petegee/PMS2/Builds/01/PMS2.jpg

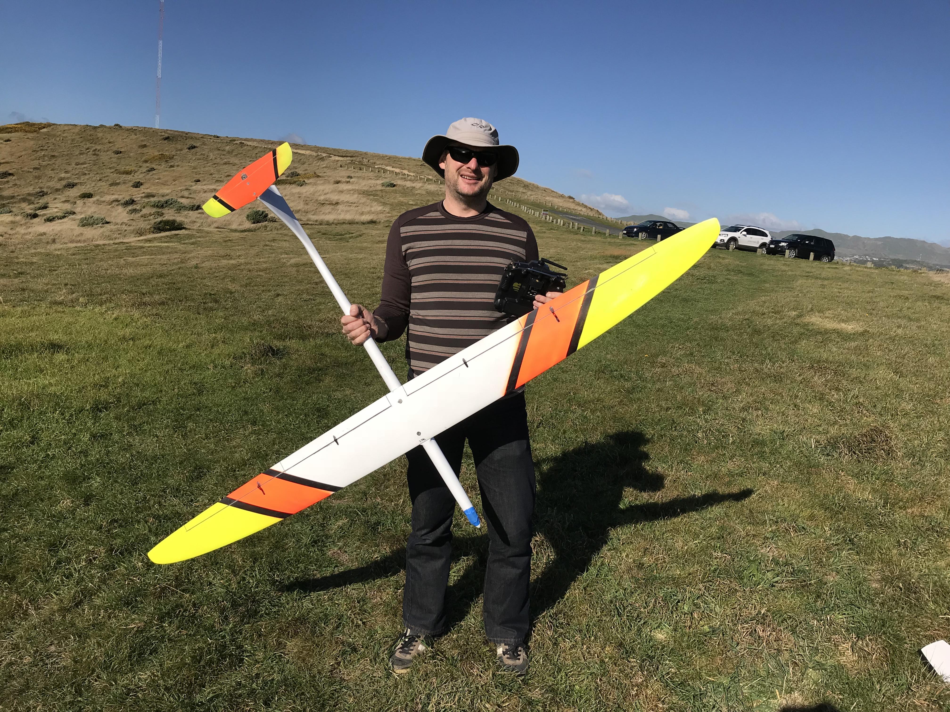
Builds/01/PMS2.jpg
