petegee/PMS2/README.md

# PMS2
A complete record of the PMS mk2 Dynamic Soaring sailplane
