petegee/PMS2/Plans/Wing/Linkages/ReadMe.md

# PMS 2 linkages

How to use these files:
1. Download and install Processing https://processing.org
2. Put the 3 folders (adjacent to this file) under the root install directory of Processing.
   you should have:
   * /pms2_flap/pms2_aileron.pde
   * /pms2_aileron/pms2_aileron.pde
   * /pms2_aileron_tophinged/pms2_aileron_tophinged.pde
3. Open one of the .pde files with processing.
4. Click the run button

https://github.com/projectkk2glider/servo-linkage
