petegee/PMS2/Plans/Overview.md

# P.M.S. mk2 

Poor Mans' Sloper Mk2 (PMS 2) is a scaled-down to 2 meter version of the PMS 3 meter slope-soarer original designed and built by Dave Pope, which was a 2-piece vac-bagged wing. The PMS 2 is intended to be a single-peice wing, heavy-weight, high-aspect, Dynamic Soaring glider which is built to be very strong and break the 300MPH barrier for local Wellington DS pilots.

The initial prototype PMS 2 was built by Dave Pope with a vac-bagged foam-cored triple-tapered elliptical plan-form with a fuselage mold built from a turned wooden plug and created from poly resin and chopped-matt glass. The air-foils were designed by Sean Malloney and are designed first and foremost for Dynamic Soaring, producing excellent DS performance from 200-400MPH with average front-side sloping performance yet being docile enough to slow down for launch and landing.

The wing moulds were build several years later by Pete Glassey. The wing design and mold CAD work was done by Joe Wurts. The CAM 3D CNC milling was done by Peter Williams. The moulds were milled from laminated corian bench-top material. 

## CoG Caclulations (old)
Note: this is based on original triple-tapered prototype planform; which should be close enough as a starting point.
https://www.ecalc.ch/cgcalc.php?deeplink=PMS%202%20(orig%20planform);cm;17;15.5;12.2;7.2;0;0;0;1.7;5;0;0;40;35;25;0;0;0.85;9;5;0;0;0;0;3;0;0;0;0;16;%20;%20;%20;0;82;25;10;

## Changes:

* new horizontal stabiliser mold has been CAD/CNC manufactured by Don Tester
* new Fuselage mold has been CAD designed and will be CNC cut sometime this year (2020) out of corian by Pete Williams

New calcs:
https://www.ecalc.ch/cgcalc.php?deeplink=PMS%202;cm;17;15.5;12.2;7.2;0;0;0;1.7;5;0;0;40;35;25;0;0;0.85;8.5;5;0;0;0;0;3;0;0;0;0;17.7;0;0;0;0;78.1;25;10;
