petegee/PMS2/Builds/01/Overview.md

# PMS2 Build no. 1 (DESTROYED)

# Objective
Build a functional mid-weight carbon version for general use and proving the wing mould for PG.

# Details 
* Owner: PG
* Maiden @ Titahi Bay May 2018
* DS Maiden @ Ngaio June 2018
  
# Parts:
1. Fuselage built by Jono using original hand-made mould
2. Wing built by PG using new CNC corian moulds
3. Stab bagged foam - cut by DP, baggged by PG.

# Speeds:
* 221 MPH June 2018
* 250 MPH Jan 2019 (RIP)
