petegee/PMS2/Plans/CGCalcBasedOnPrototypePlanform_with_mk2_fuselage_and_mk2_stab.md

Click the perma-link for the calculations for the PMS2 based on:
1. Prototype wing planform (triple-tapered), not exactly the same as the final CAD wing
2. Using the dimensions of the new Mk2 fuselage
3. Using the planform of the new Mk2 stabiliser

Results of calculation below are to be taken as a guide only.

https://www.ecalc.ch/cgcalc.php?deeplink=PMS%202;cm;17;15.5;12.2;7.2;0;0;0;1.7;5;0;0;40;35;25;0;0;0.85;8.5;5;0;0;0;0;3;0;0;0;0;17.7;0;0;0;0;78.1;25;10;
