petegee/PMS2/Plans/NewStab/Details.md

# Mk2 Horizontal Stabiliser Details

A new horizontal stabiliser CAD/CNC mould has been made to replace the hand-made hot-wired/bagged ones with the following measurements:

# Dimensions
* Span 340mm
* Root Chord 85mm
* Tip chord 55mm
* TE Swept forward 14mm at each end.
* Flap is cut 25mm at root from TE and is 250mm in length (will be 13.5mm at ends from TE)
* 2x Mount holes are along the centreline at 15mm from LE, and 46 from the TE.
* Section: T.B.C. (but generic symetrical stabiliser section)
