petegee/PMS2/Plans/Stab/Details.md

# Horizontal Stabiliser Details

# Dimensions
* Span 320mm
* Root Chord 90mm
* Tip chord 55mm
* TE Swept forward 14mm at each end.
* Flap is cut 26mm at root from TE and is 240mm in length (will be 14mm at ends from TE)
* 2x Mount holes are along the centreline at 15mm from LE, and 46 from the TE.
* Section: T.B.C. (but generic symetrical stabiliser section)
