petegee/PMS2/Plans/Fuselage/Details.md

# Fuselage Details

## General Dimensions
* length: 1200mm 
* Nose moment (from LE of wing) 300mm
* Wing root chord (saddle length) 170mm
* Tail moment (from wing TE to stab LE) 650mm
* Tail mounted 130mm above fuselage datum
* Incidence angle (wing/stab) 0 degrees
