petegee/PMS2/Plans/Wing/Prototype info/PMS 2 Wing 02.pdf

170 | 155
400 | 350 | 250

122
72 Flap and aileron hinge: 80% chord

17
33
SM PMS 2 Root | SM PMS 2 Root | SM PMS 2 Mid | SM PMS 2 Tip
