petegee/PMS2/Plans/CGCalcBasedOnPrototypePlanform.PNG

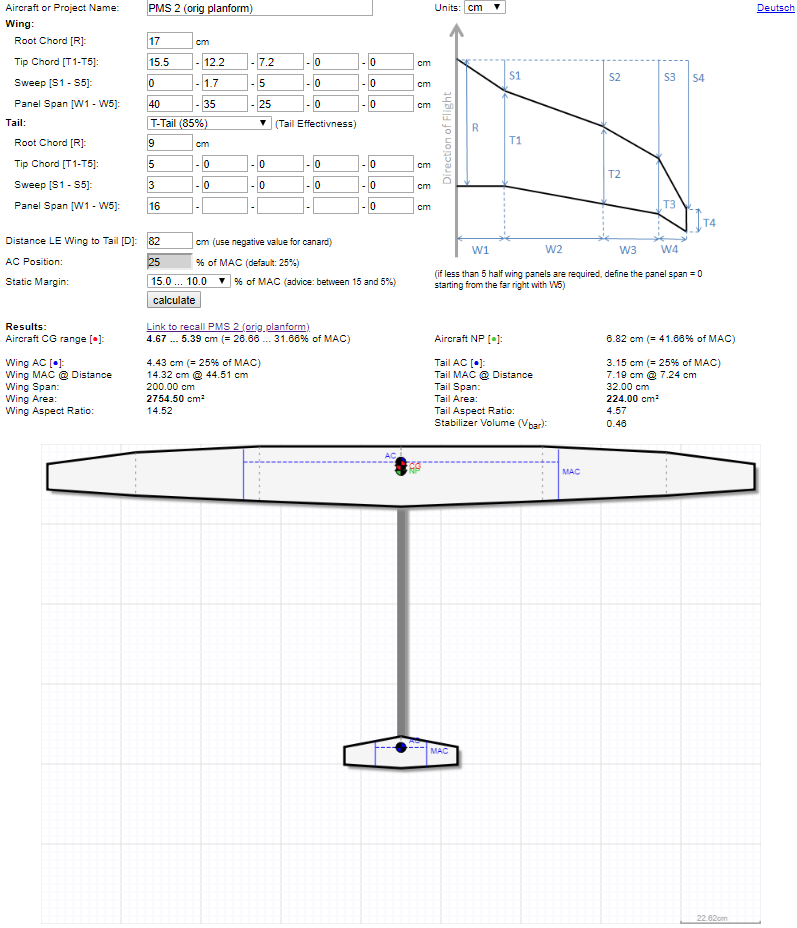
Plans/CGCalcBasedOnPrototypePlanform.PNG
