petegee/PMS2/Plans/NewFuselage/fairing-detail.png

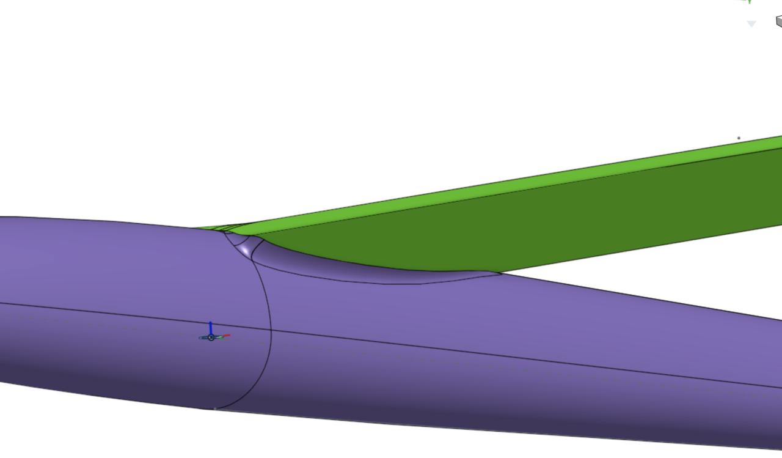
Plans/NewFuselage/fairing-detail.png
