petegee/PMS2/Plans/NewFuselage/SideView.JPG

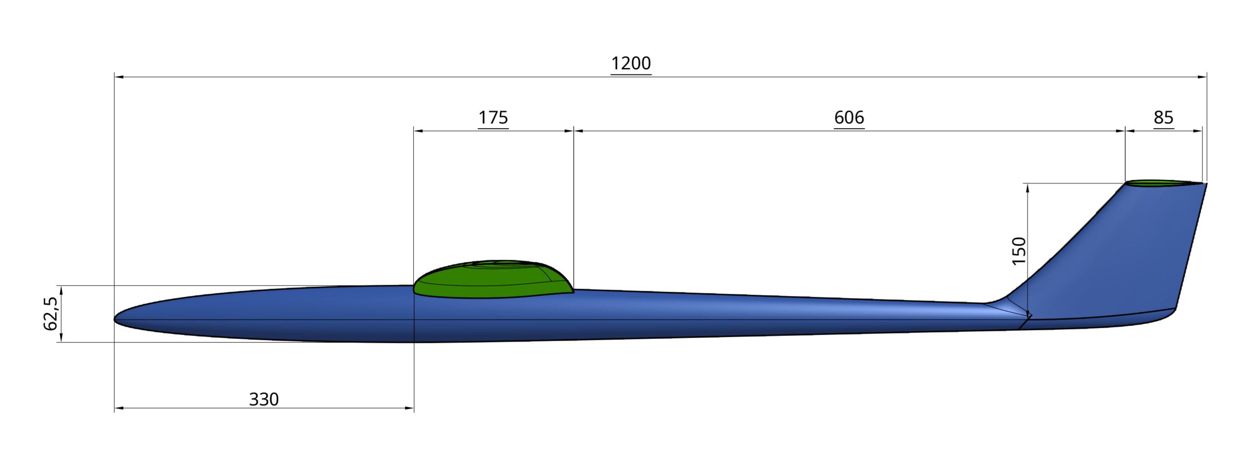
Plans/NewFuselage/SideView.JPG
