petegee/PMS2/Plans/Wing/Mold STEP files/lower mold v3.stp

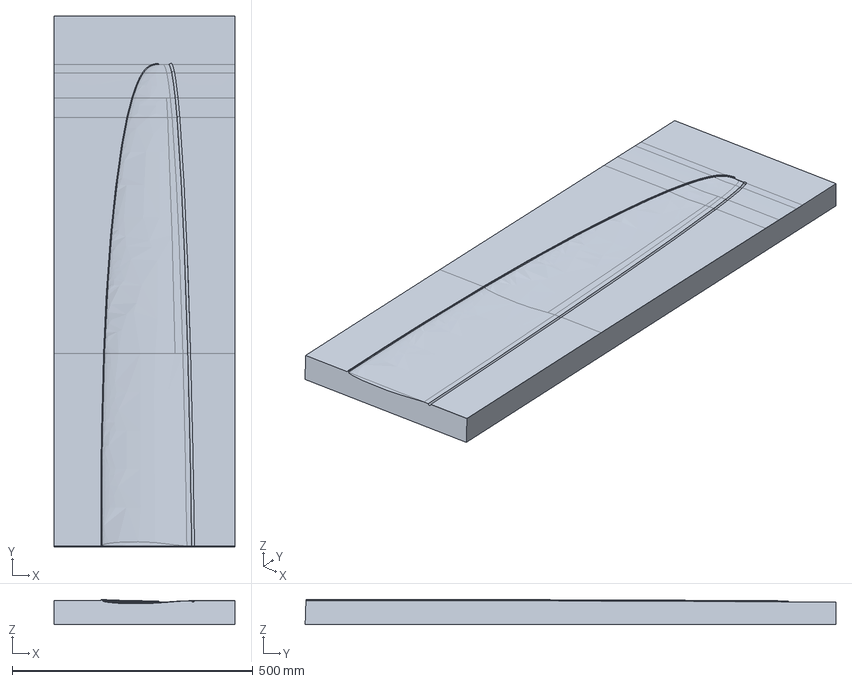
[picture p5: CAD file, 2018-05-05]
Plans/Wing/Mold STEP files/lower mold v3.stp
375.7 x 1101.7 x 52.0 mm
