petegee/PMS2/Plans/Wing/PMS2 Wing v3 Files/PMS2 Wing loft v3 dihedral.stp

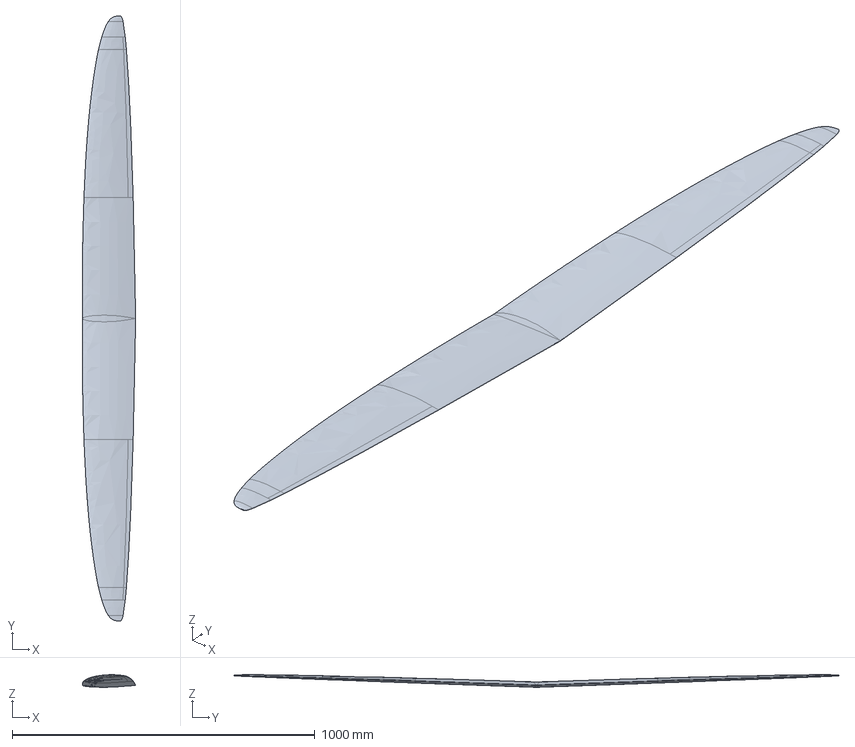
[picture p6: CAD file, 2018-06-27]
Plans/Wing/PMS2 Wing v3 Files/PMS2 Wing loft v3 dihedral.stp
176.2 x 1999.0 x 41.7 mm
