petegee/PMS2/Plans/Wing/Mold STEP files/upper mold v3.stp

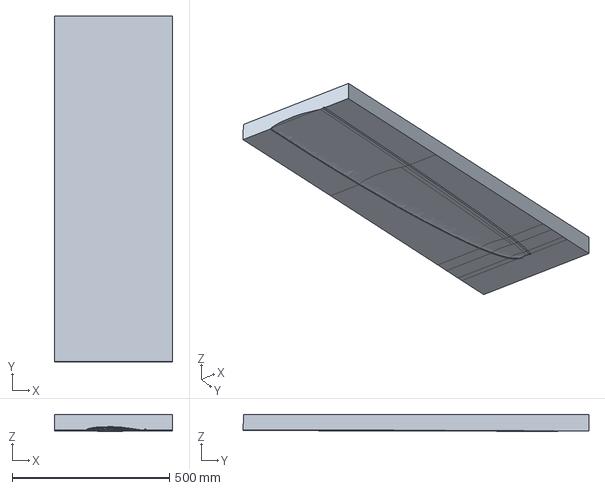
[picture p7: CAD file, 2018-05-05]
Plans/Wing/Mold STEP files/upper mold v3.stp
375.7 x 1100.1 x 54.9 mm
