petegee/PMS2/Builds/01/Fuselage.md

# Fuselage

## Details
Built from DP's original hand-made moulds using joggle. 

## Construction
1. Hollow-moulded Carbon, Carbon-Kevlar, FG with joggle seam built by JA.

## Layup
1. Fucking heavy of unknown Jono layup
