petegee/PMS2/(commit log)

2018-05-07 moving files and adding initial wing info
    [lower mold v3.stp, upper mold v3.stp]
2018-06-27 added wing stp files misc renames
    [PMS2 Wing loft v3 dihedral.stp, lower mold v3.stp, upper mold v3.stp]
2018-06-27 more wing build #1 details
2020-05-11 added new fuselage details
2020-05-11 added more details about the new stab and fuselage models and new calculations
