petegee/PMS2/(notices)

Notices in the files:
Plans/Wing/Linkages/pms2_aileron/pms2_aileron.pde:
This program is free software; you can redistribute it and/or modify
it under the terms of the GNU General Public License version 2 as
published by the Free Software Foundation.
